RyanScottLewis/thermoclock/(list of files, drawings)

Other design files:
doc/Schematic.fzz
