RyanScottLewis/thermoclock/(commit log)

2018-05-09 Remove debugging in driver
2018-05-09 Remove redundant check in write function of char driver
2018-05-09 Use 80MHz for SPI bus speed (80% of max speed) for now
2018-05-09 Add schematic
    [Schematic.fzz]
2018-05-23 Docs: Readme and external timer idea
